Mr-Bossman/usbPB-ThinkPad/README.md

# usbPB-ThinkPad
A usb PD converter for lenovo slim tip chargers

Writen in C, small ram and code space.
