Mr-Bossman/usbPB-ThinkPad/board/USBPD.kicad_pcb

## KiCad design board/USBPD.kicad_pcb (2023-01-27)

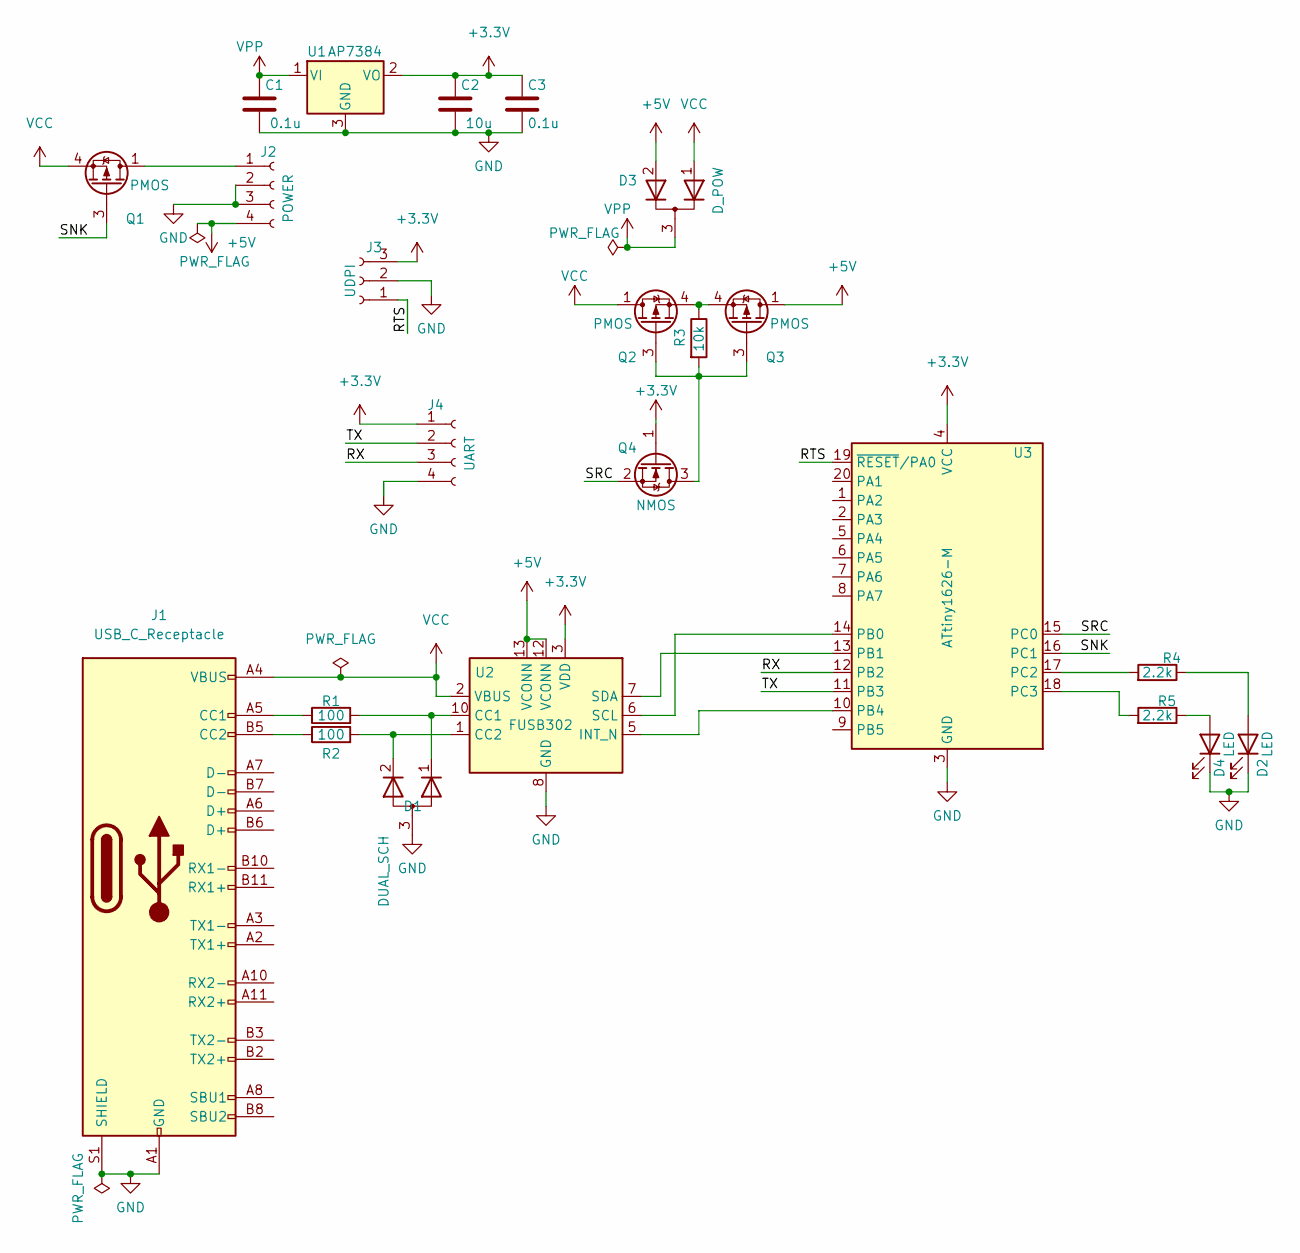
[picture p1: schematic USBPD.kicad_sch]

Parts:
C1, C3: 0.1u; C_0603_1608Metric
C2: 10u; C_0603_1608Metric
D1: DUAL_SCH; SOT-23
D2, D4: LED; LED_0603_1608Metric
D3: D_POW; SOT-23
J1: USB_C_Receptacle; USB_C_Receptacle_GCT_USB4085
J2: POWER; PinHeader_1x04_P2.54mm_Vertical
J3: UDPI; SolderJumper-3_P1.3mm_Open_RoundedPad1.0x1.5mm_NumberLabels
J4: UART; Molex_PicoBlade_53047-0410_1x04_P1.25mm_Vertical
Q1, Q2, Q3: PMOS; SOT-23-6
Q4: NMOS; SOT-23
R1, R2: 100; R_0603_1608Metric
R3: 10k; R_0603_1608Metric
R4, R5: 2.2k; R_0603_1608Metric
U1: AP7384; SOT-23
U2: FUSB302; WQFN-14-1EP_2.5x2.5mm_P0.5mm_EP1.45x1.45mm
U3: ATtiny1626-M; VQFN-20-1EP_3x3mm_P0.4mm_EP1.7x1.7mm

Connections:
+3.3V: C2.1, C3.1, J3.3, J4.1, Q4.1 (G), U1.2 (VO), U2.3 (VDD), U2.4 (VDD), U3.4 (VCC)
+5V: D3.2 (K), J2.4, Q3.1 (D), Q3.2 (D), Q3.5 (D), Q3.6 (D), U2.12 (VCONN), U2.13 (VCONN)
/RTS: J3.1, U3.19 (~RESET/PA0)
/RX: J4.3, U3.12 (PB2)
/SNK: Q1.3 (G), U3.16 (PC1)
/SRC: Q4.2 (S), U3.15 (PC0)
/TX: J4.2, U3.11 (PB3)
GND: C1.2, C2.2, C3.2, D1.3 (A), D2.1 (K), D4.1 (K), J1.A1 (GND), J1.A12 (GND), J1.B1 (GND), J1.B12 (GND), J1.S1 (SHIELD), J2.2, J2.3, J3.2, J4.4, U1.3 (GND), U2.8 (GND), U2.9 (GND), U2.15 (GND), U3.3 (GND), U3.21 (GND)
unnamed: D1.1 (K), R1.2, U2.10 (CC1), U2.11 (CC1)
unnamed: D1.2 (K), R2.2, U2.1 (CC2), U2.14 (CC2)
unnamed: D2.2 (A), R4.1
unnamed: D4.2 (A), R5.1
unnamed: J1.A5 (CC1), R1.1
unnamed: J1.B5 (CC2), R2.1
unnamed: J2.1, Q1.1 (D), Q1.2 (D), Q1.5 (D), Q1.6 (D)
unnamed: Q2.3 (G), Q3.3 (G), Q4.3 (D), R3.2
unnamed: Q2.4 (S), Q3.4 (S), R3.1
unnamed: R4.2, U3.17 (PC2)
unnamed: R5.2, U3.18 (PC3)
unnamed: U2.5 (INT_N), U3.10 (PB4)
unnamed: U2.6 (SCL), U3.14 (PB0)
unnamed: U2.7 (SDA), U3.13 (PB1)
VCC: D3.1 (K), J1.A4 (VBUS), J1.A9 (VBUS), J1.B4 (VBUS), J1.B9 (VBUS), Q1.4 (S), Q2.1 (D), Q2.2 (D), Q2.5 (D), Q2.6 (D), U2.2 (VBUS)
VPP: C1.1, D3.3 (A), U1.1 (VI)

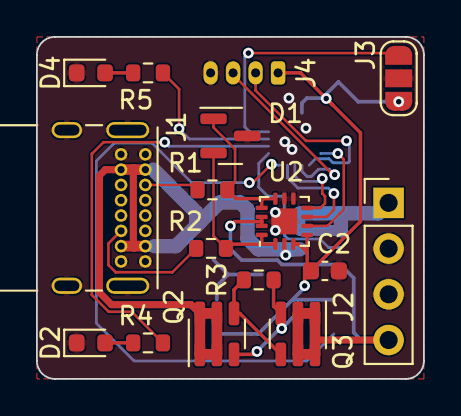
[picture p2: board USBPD.kicad_pcb from above]

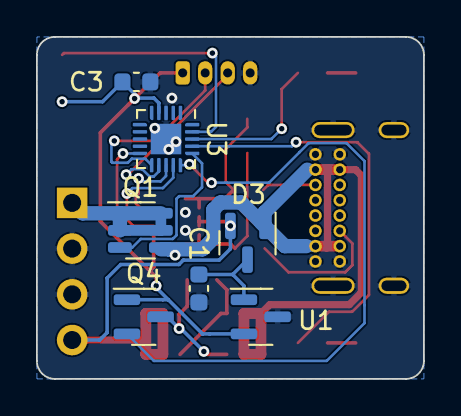
[picture p3: board USBPD.kicad_pcb from below]

Board: 2 copper layers, 21.5 x 19.0 mm, 23 parts (7 on the bottom side), 24 nets.
