Mr-Bossman/usbPB-ThinkPad/include/pit.h

#ifndef __PIT_H__
#define __PIT_H__


/* Init Pit timer */
void pit_init();

/* Wait for timeout period *32ms */
bool wait_for_timerlock(uint16_t timeout);

/* Start timer */
void start_timer();

/* Get timer value *32ms */
uint16_t get_timer(void);

/* Set callback function for WDT */
void set_timer_callback(void (*callback)(void));

/* Enable/Disable interrupt */
void pit_IE(uint8_t IE);

#define break_out(timeout)if (!wait_for_timerlock(timeout)) break

#endif /* __PIT_H__ */
