Mr-Bossman/usbPB-ThinkPad/(commit log)

2022-09-05 i2c works now and started usb302 setup
2022-09-06 print caps
2022-09-08 another bug cant reset b4 detach
    [main.c]
2022-09-11 usbPD board init
    [USBPD.kicad_pcb, USBPD.kicad_sch]
2022-11-04 update pcb
    [USBPD.kicad_pcb, USBPD.kicad_sch]
2022-11-14 usb pd state machine mostly implemented just need reset and err detection now
    [fusb302.c, fusb302.h, main.c]
2022-11-14 should work using 5v and power up
2023-01-23 works with terminated usbc cables
2023-01-27 use LVL translator for switch
    [USBPD.kicad_pcb, USBPD.kicad_sch]
